Shukti042/Self-Driven-Vacuum-Cleaner/Project/Robot Driving with ATmega32/Circuit Diagram/Robot Driving with ATmega32.jpg

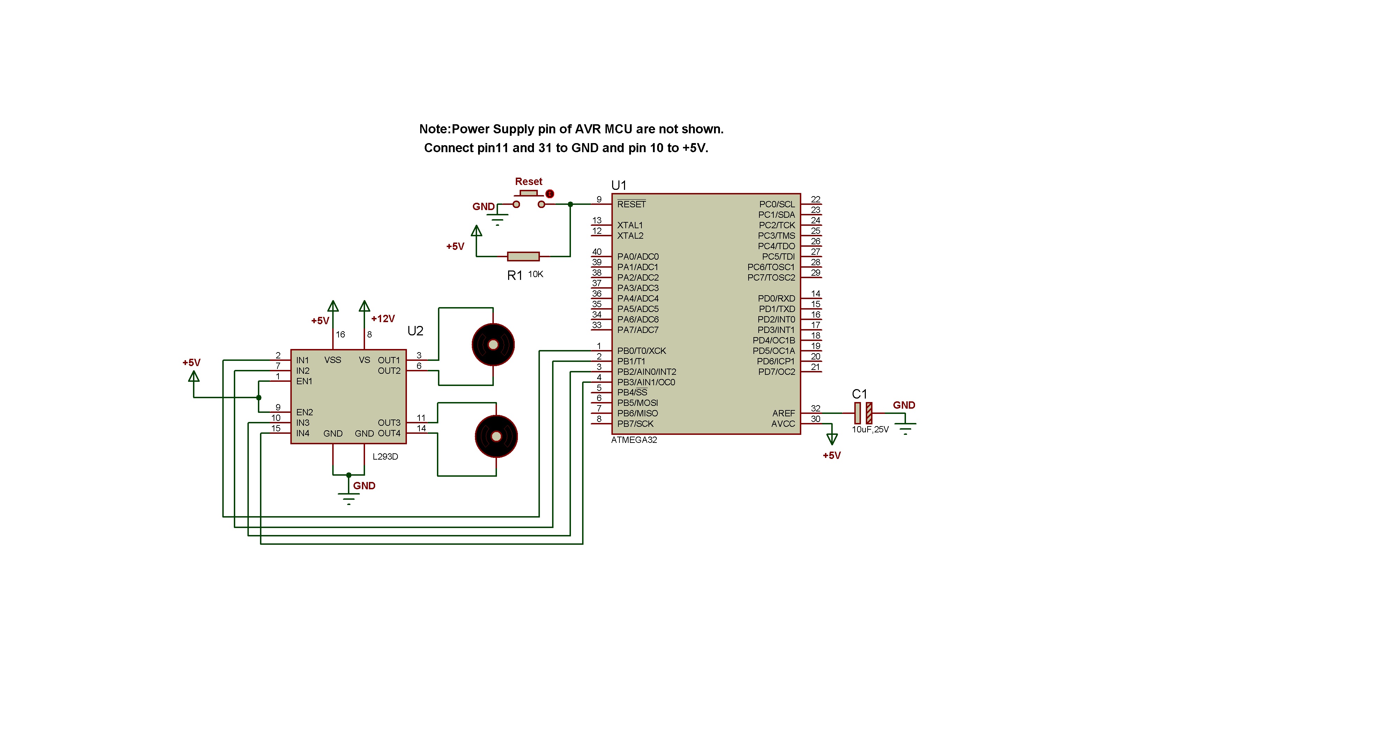
Project/Robot Driving with ATmega32/Circuit Diagram/Robot Driving with ATmega32.jpg
